cluelessgumshoe/3d_spidey-disc-launcher/mk3/images/mk3_cartridge_parts.png

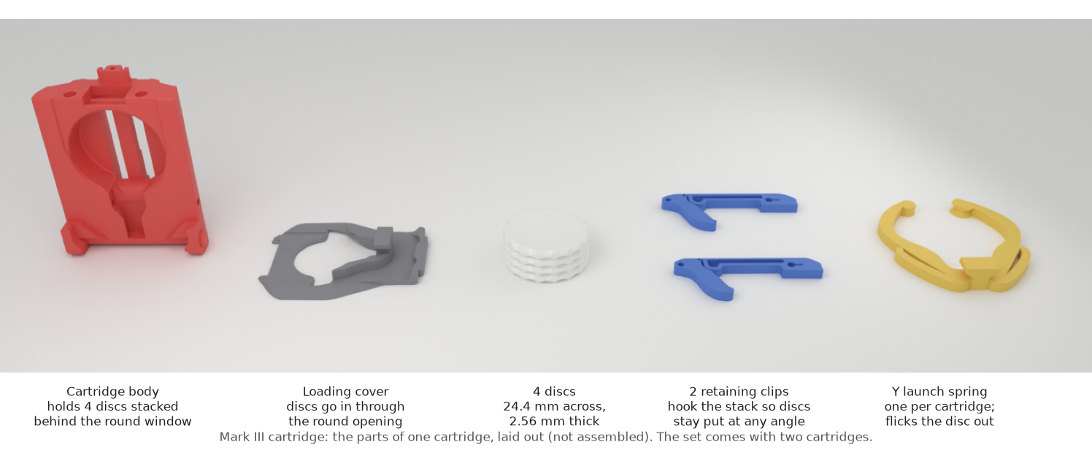
mk3/images/mk3_cartridge_parts.png
