cluelessgumshoe/3d_spidey-disc-launcher/mk3/stl/Assembly_part.stl

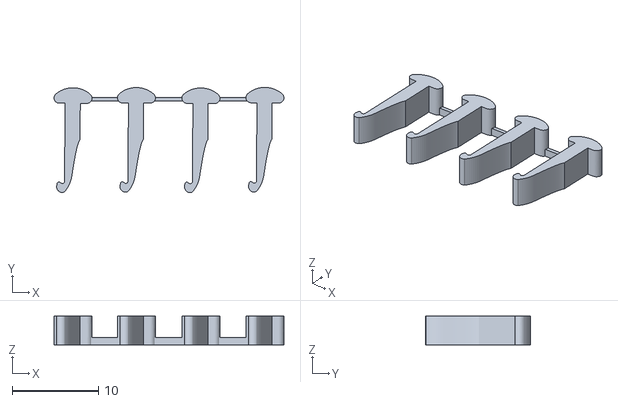
[picture p5: CAD file, 2026-10-16]
mk3/stl/Assembly_part.stl
26.7 x 12.2 x 3.33
