cluelessgumshoe/3d_spidey-disc-launcher/mk3/mk3_all_plates_kobra3.3mf

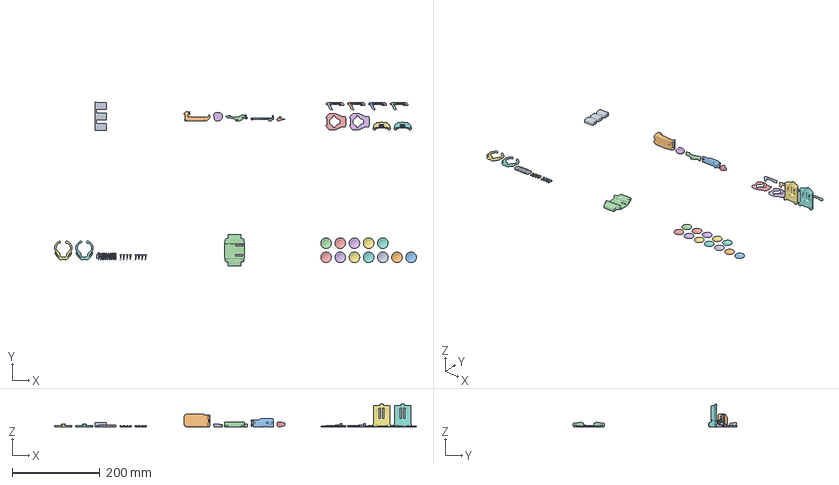
[picture p6: CAD file, 2026-10-30]
mk3/mk3_all_plates_kobra3.3mf
826.5 x 373.7 x 52.2 mm
watch_fit_coupon_v3
Pusher
Trigger_Lever
Trigger_PalmPad
Trigger_Button
Cartridge_Body_1
Cartridge_Body_2
Cartridge_Clip_C_1
Cartridge_Clip_C_2
Cartridge_Clip_D_1
Cartridge_Clip_D_2
Cartridge_LoadingCover_1
Cartridge_LoadingCover_2
Launch_Spring_Y_1
Launch_Spring_Y_2
Return_Spring_printed
Assembly_part_1
Assembly_part_2
wrist_base_watchband
Disc_small_1
Disc_small_2
Disc_small_3
Disc_small_4
Disc_small_5
Disc_small_6
Disc_small_7
Disc_small_8
Disc_small_9
Disc_small_10
Disc_small_11
Disc_small_12
