cluelessgumshoe/3d_spidey-disc-launcher/mk3/original/Launch_Spring_Y.stl

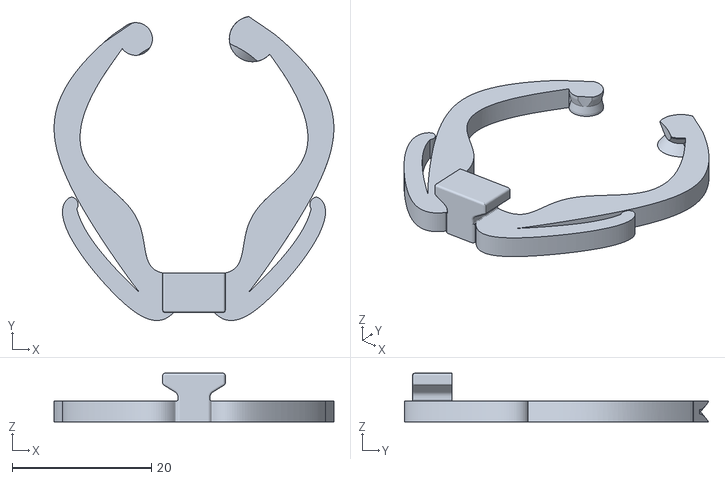
[picture p7: CAD file, 2026-10-16]
mk3/original/Launch_Spring_Y.stl
40.2 x 43.7 x 6.98
