cluelessgumshoe/3d_spidey-disc-launcher/mk3/plates/plate1_any_color_fit_test_v3_kobra3.3mf

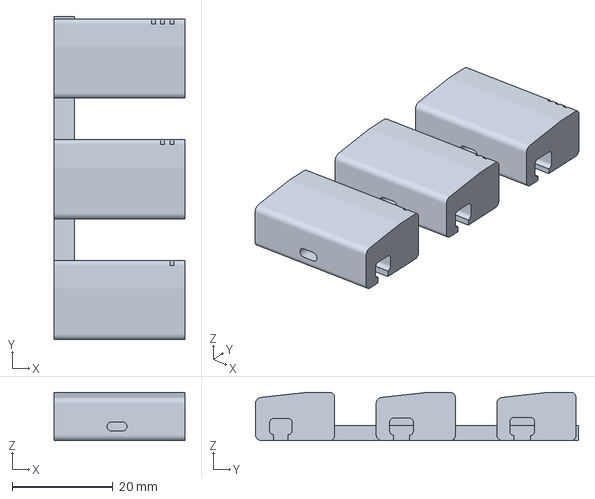
[picture p8: CAD file, 2026-10-30]
mk3/plates/plate1_any_color_fit_test_v3_kobra3.3mf
26.0 x 64.2 x 9.60 mm
