cluelessgumshoe/3d_spidey-disc-launcher/mk3/stl/Trigger_Lever.stl

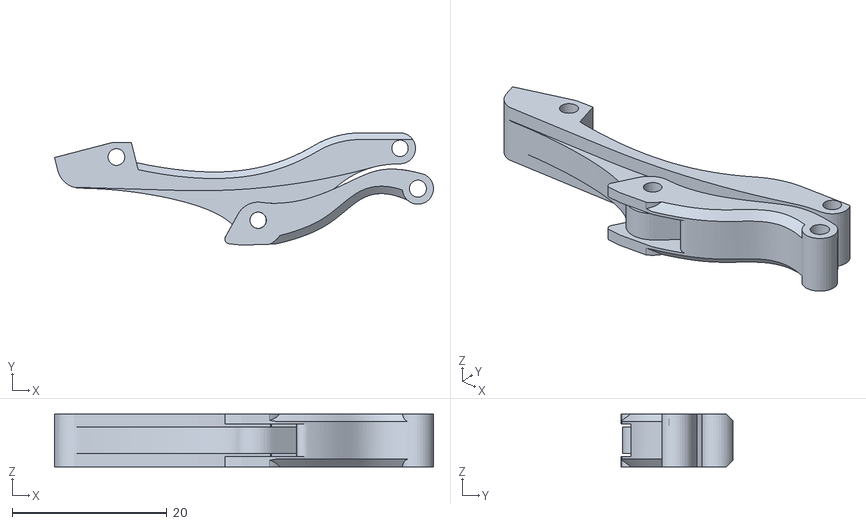
[picture p9: CAD file, 2026-10-16]
mk3/stl/Trigger_Lever.stl
48.9 x 14.5 x 6.84
