cluelessgumshoe/3d_spidey-disc-launcher/mk3/original/WristLock.stl

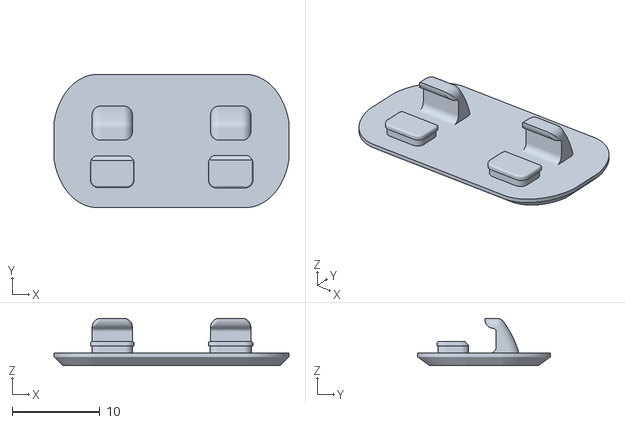
[picture p10: CAD file, 2026-10-16]
mk3/original/WristLock.stl
26.8 x 15.2 x 5.41
