cluelessgumshoe/3d_spidey-disc-launcher/mk3/plates/plate4_black_springs_and_pins_kobra3.3mf

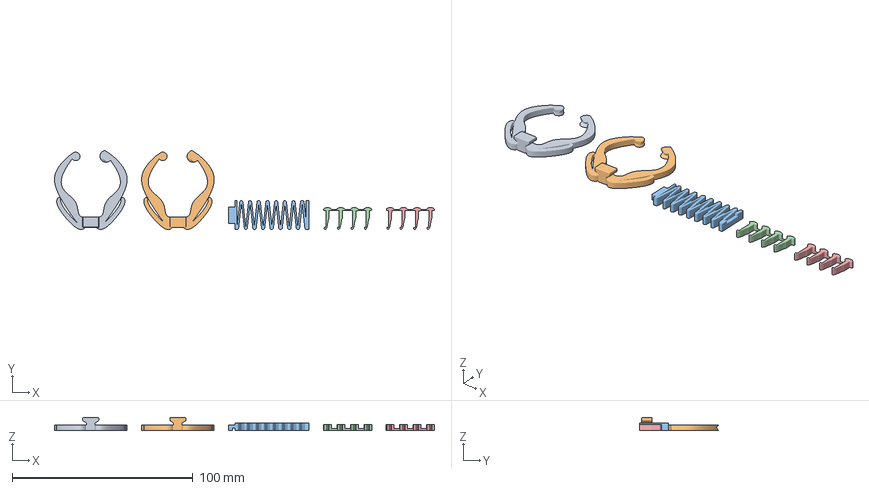
[picture p11: CAD file, 2026-10-30]
mk3/plates/plate4_black_springs_and_pins_kobra3.3mf
210.4 x 43.7 x 6.98 mm
Launch_Spring_Y_1
Launch_Spring_Y_2
Return_Spring_printed
Assembly_part_1
Assembly_part_2
