cluelessgumshoe/3d_spidey-disc-launcher/mk3/stl/Trigger_PalmPad.stl

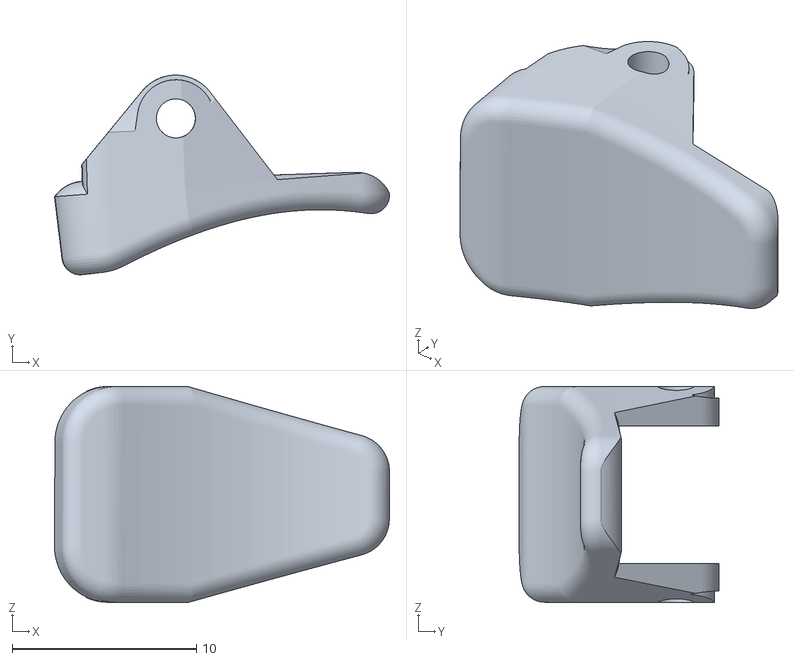
[picture p12: CAD file, 2026-10-16]
mk3/stl/Trigger_PalmPad.stl
18.2 x 10.8 x 11.7
