cluelessgumshoe/3d_spidey-disc-launcher/mk3/original/Cartridge_Clip_C.stl

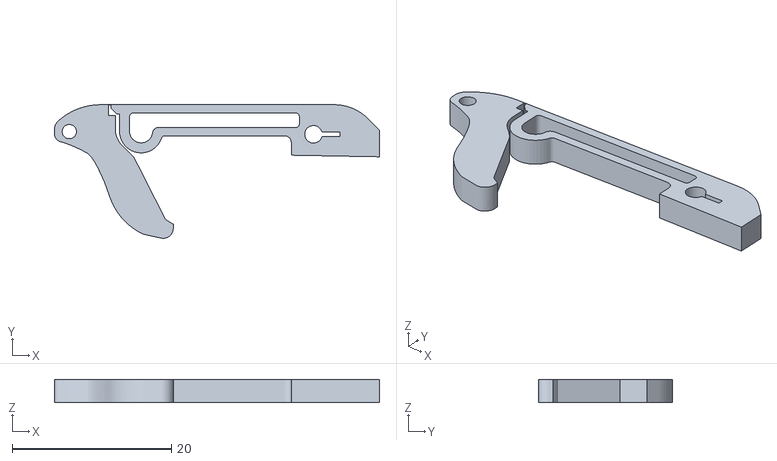
[picture p13: CAD file, 2026-10-16]
mk3/original/Cartridge_Clip_C.stl
40.8 x 16.8 x 2.90
