cluelessgumshoe/3d_spidey-disc-launcher/mk3/plates/plate2_red_launcher_kobra3.3mf

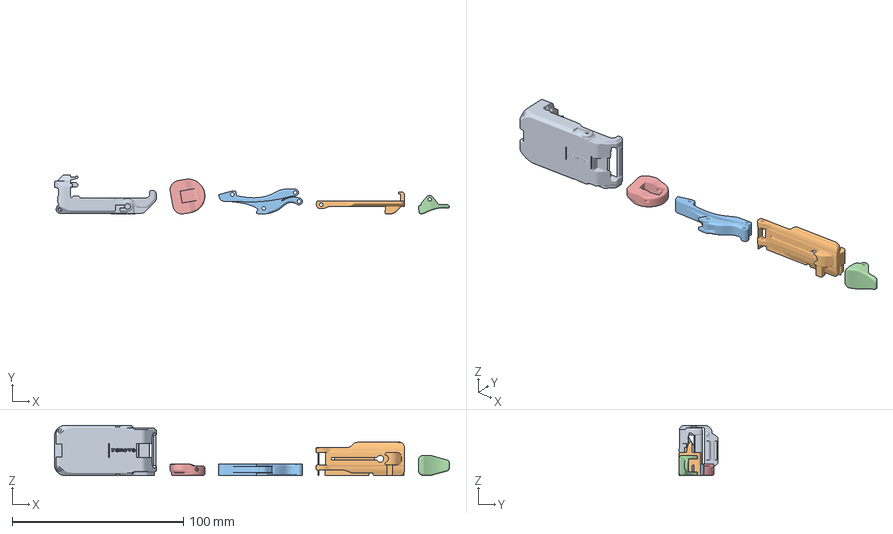
[picture p14: CAD file, 2026-10-30]
mk3/plates/plate2_red_launcher_kobra3.3mf
230.6 x 22.7 x 29.2 mm
Pusher
Trigger_Lever
Trigger_PalmPad
Trigger_Button
