cluelessgumshoe/3d_spidey-disc-launcher/mk3/original/WristStrap.stl

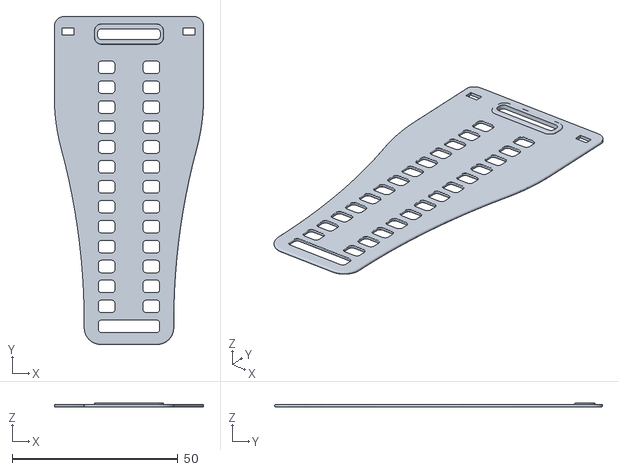
[picture p15: CAD file, 2026-10-16]
mk3/original/WristStrap.stl
45.0 x 98.8 x 1.20
