cluelessgumshoe/3d_spidey-disc-launcher/mk3/plates/plate3_black_cartridges_kobra3.3mf

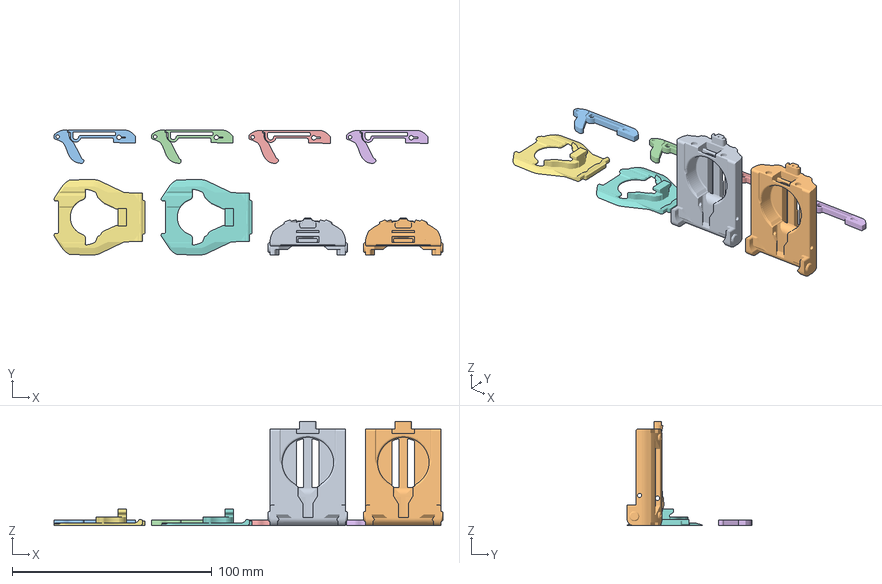
[picture p16: CAD file, 2026-10-30]
mk3/plates/plate3_black_cartridges_kobra3.3mf
194.9 x 62.7 x 52.2 mm
Cartridge_Body_1
Cartridge_Body_2
Cartridge_Clip_C_1
Cartridge_Clip_C_2
Cartridge_Clip_D_1
Cartridge_Clip_D_2
Cartridge_LoadingCover_1
Cartridge_LoadingCover_2
