cluelessgumshoe/3d_spidey-disc-launcher/mk3/plates/plate6_any_color_discs_kobra3.3mf

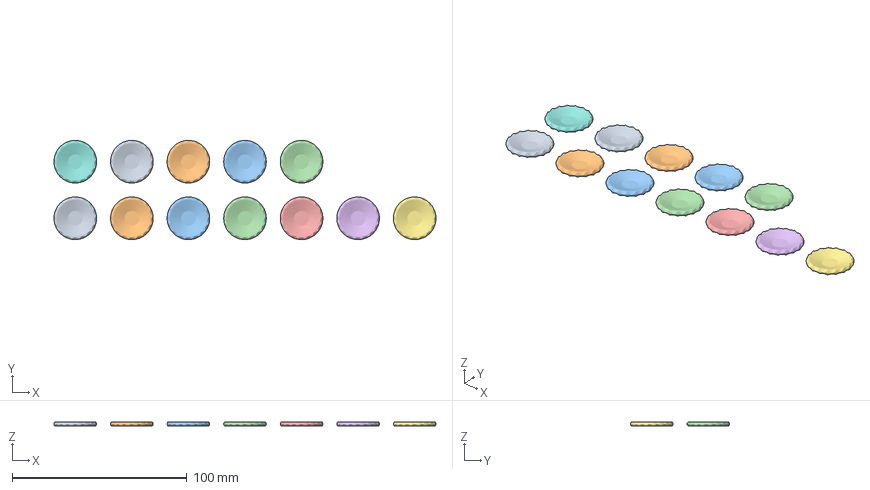
[picture p17: CAD file, 2026-10-30]
mk3/plates/plate6_any_color_discs_kobra3.3mf
218.6 x 56.7 x 2.56 mm
Disc_small_1
Disc_small_2
Disc_small_3
Disc_small_4
Disc_small_5
Disc_small_6
Disc_small_7
Disc_small_8
Disc_small_9
Disc_small_10
Disc_small_11
Disc_small_12
