cluelessgumshoe/3d_spidey-disc-launcher/mk3/stl/Pusher.stl

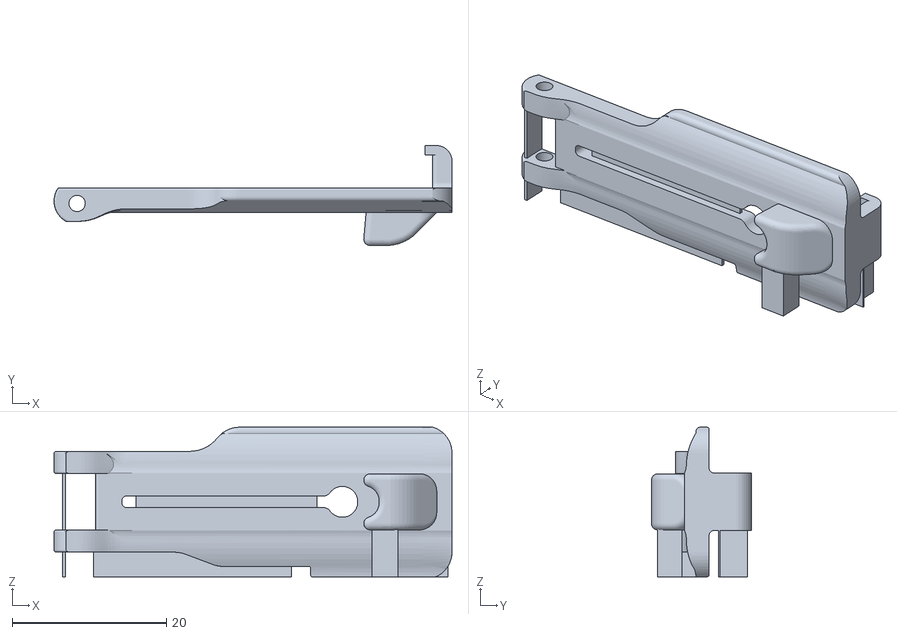
[picture p18: CAD file, 2026-10-16]
mk3/stl/Pusher.stl
51.6 x 13.0 x 19.4
