cluelessgumshoe/3d_spidey-disc-launcher/mk3/plates/plate5_red_wrist_base_kobra3.3mf

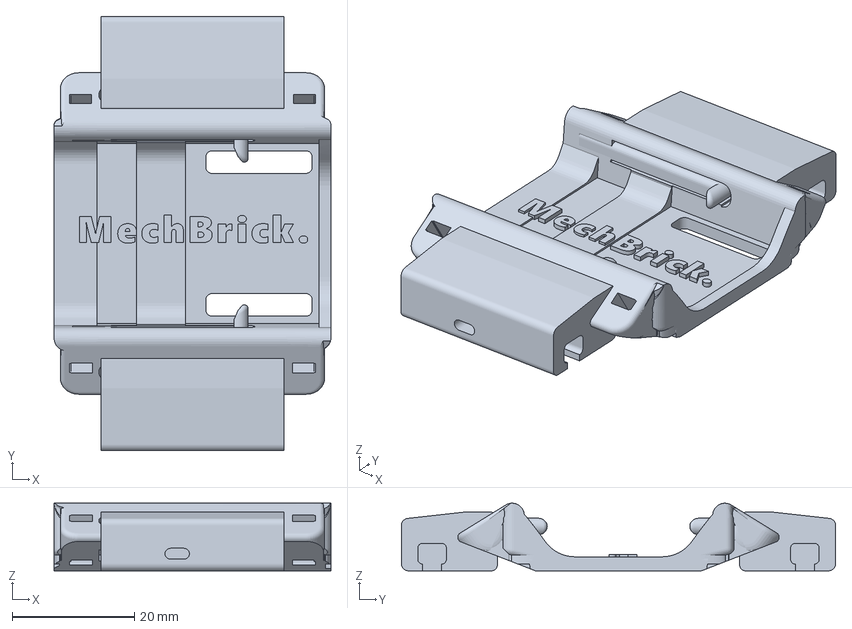
[picture p19: CAD file, 2026-10-30]
mk3/plates/plate5_red_wrist_base_kobra3.3mf
45.4 x 71.2 x 11.1 mm
