cluelessgumshoe/3d_spidey-disc-launcher/mk3/original/Cartridge_LoadingCover.stl

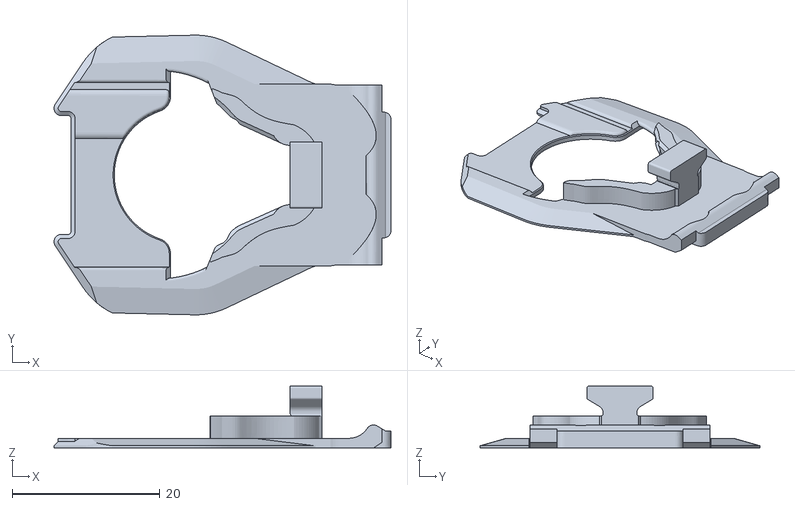
[picture p20: CAD file, 2026-10-16]
mk3/original/Cartridge_LoadingCover.stl
45.6 x 37.9 x 8.38
