cluelessgumshoe/3d_spidey-disc-launcher/mk3/original/Cartridge_Clip_D.stl

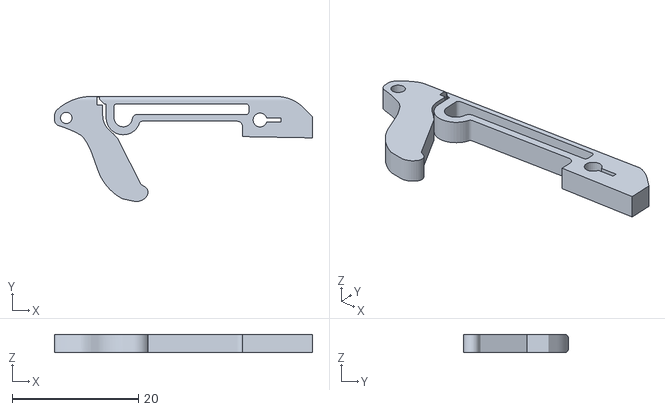
[picture p21: CAD file, 2026-10-16]
mk3/original/Cartridge_Clip_D.stl
40.8 x 16.6 x 2.90
