cluelessgumshoe/3d_spidey-disc-launcher/mk3/stl/Trigger_Button.stl

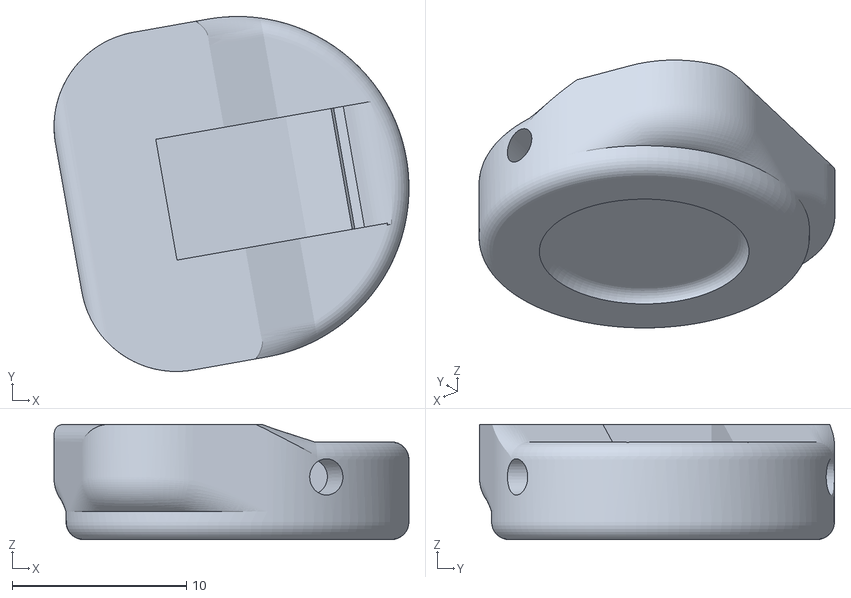
[picture p22: CAD file, 2026-10-16]
mk3/stl/Trigger_Button.stl
20.3 x 20.3 x 6.60
