cluelessgumshoe/3d_spidey-disc-launcher/mk3/original/WristBase.stl

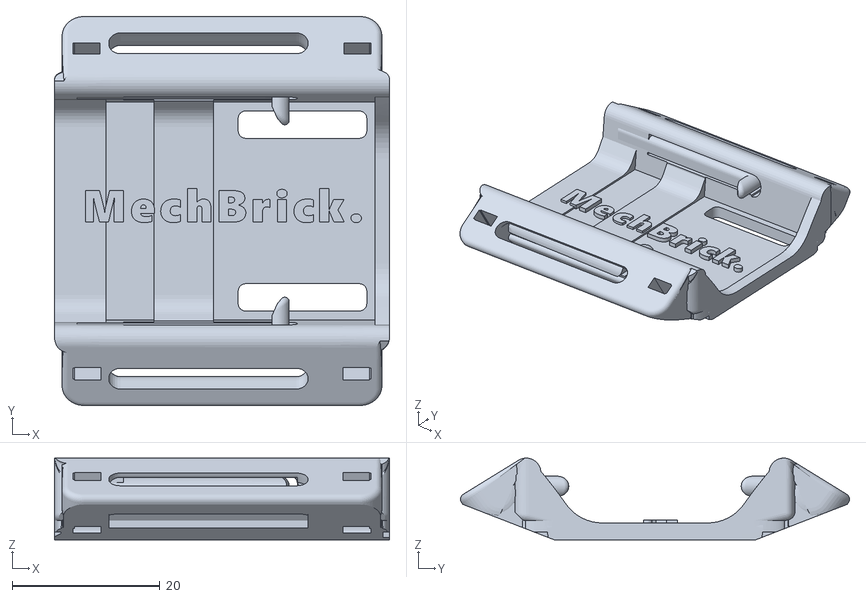
[picture p23: CAD file, 2026-10-16]
mk3/original/WristBase.stl
45.4 x 52.7 x 11.1
