cluelessgumshoe/3d_spidey-disc-launcher/mk3/stl/Disc_small.stl

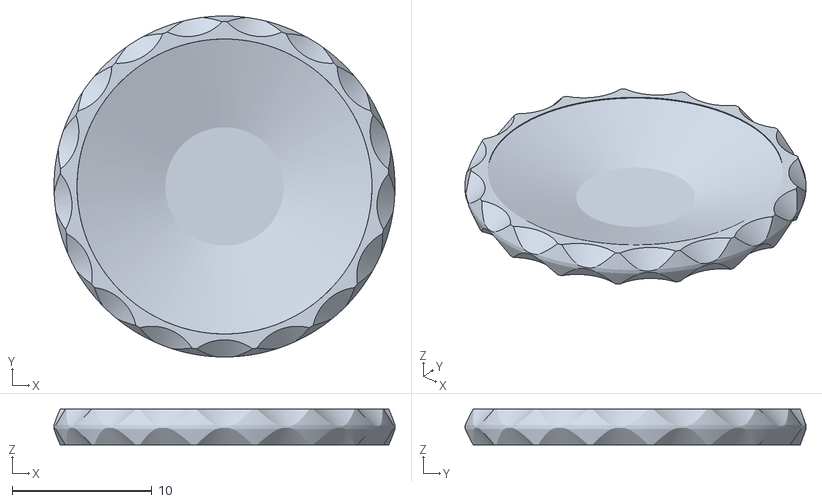
[picture p24: CAD file, 2026-10-16]
mk3/stl/Disc_small.stl
24.4 x 24.4 x 2.56
