cluelessgumshoe/3d_spidey-disc-launcher/mk3/stl/Cartridge_Body.stl

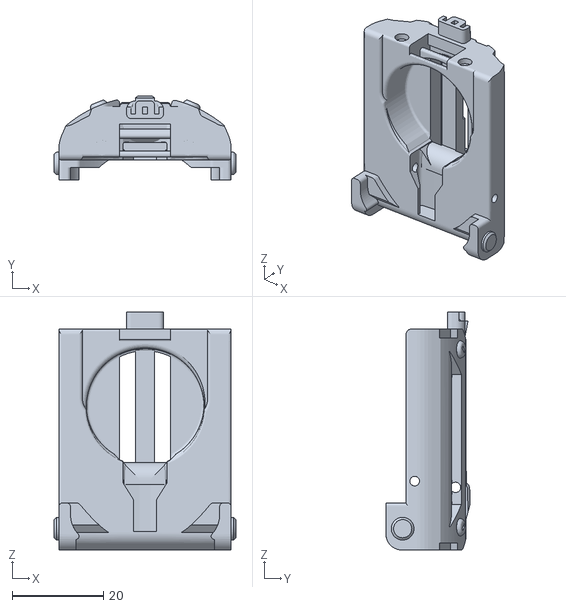
[picture p25: CAD file, 2026-10-16]
mk3/stl/Cartridge_Body.stl
39.8 x 18.5 x 52.2
