cluelessgumshoe/3d_spidey-disc-launcher/mk3/original/Return_Spring_printed.stl

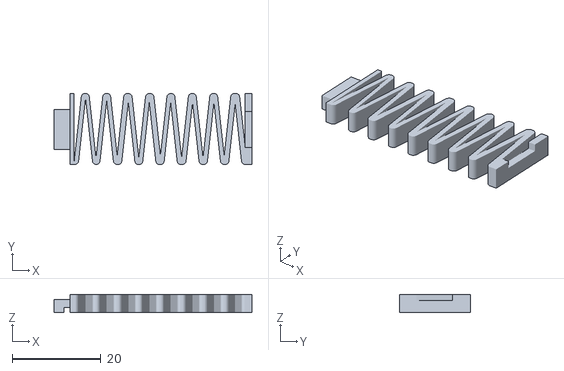
[picture p26: CAD file, 2026-10-16]
mk3/original/Return_Spring_printed.stl
44.5 x 16.0 x 4.14
