cluelessgumshoe/3d_spidey-disc-launcher/mk3/original/Body.stl

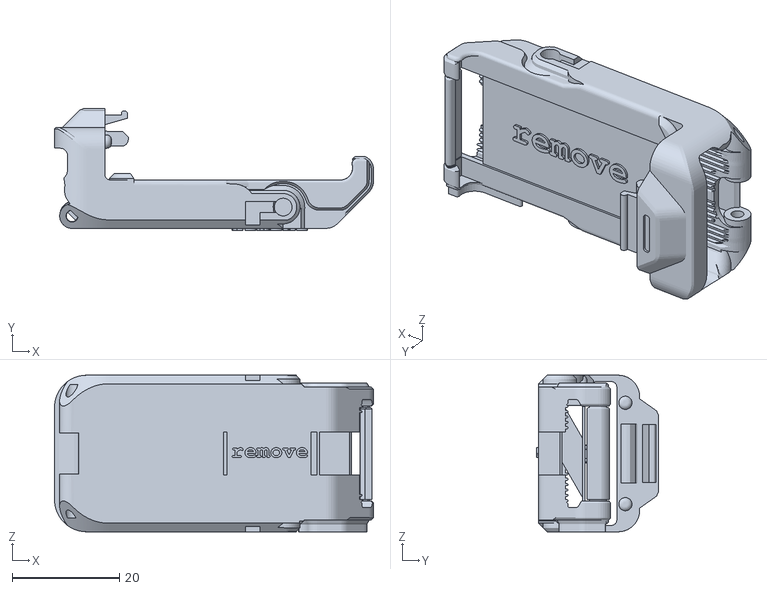
[picture p27: CAD file, 2026-10-16]
mk3/original/Body.stl
59.5 x 22.7 x 29.2
