cluelessgumshoe/3d_spidey-disc-launcher/mk3/original/WristStrap_L.stl

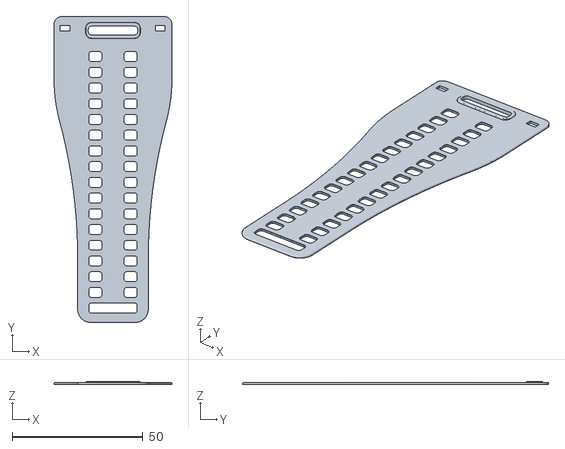
[picture p28: CAD file, 2026-10-16]
mk3/original/WristStrap_L.stl
45.0 x 116.8 x 1.20
