cluelessgumshoe/3d_spidey-disc-launcher/(list of files, cad)

Other CAD files:
mk3/stl/watch_fit_coupon_v3.stl
mk3/original/Trigger_Lever.stl
mk3/stl/wrist_base_watchband.stl
mk1/original/DWS_Main_Body_Short_v2.stl
mk1/original/DWS_WristMount_Body_v4.stl
mk1/original/Disc.stl
mk1/original/parts/Link2_Cap.stl
mk1/original/parts/Link2_Lever.stl
mk1/original/parts/Link3.stl
mk1/original/parts/Link3_Pad.stl
mk1/original/parts/Pusher_A.stl
mk1/original/parts/Pusher_B.stl
mk1/original/parts/Slider.stl
mk1/original/parts/Slider_Retainer.stl
mk1/original/parts/Spring.stl
mk1/original/parts/SpringLockPin.stl
mk1/plates/optional_plate_only_kobra3.3mf
mk1/plates/plate1_any_color_fit_test_kobra3.3mf
mk1/plates/plate2_red_launcher_kobra3.3mf
mk1/plates/plate3_black_mechanism_kobra3.3mf
mk1/plates/plate4_any_color_discs_kobra3.3mf
mk1/plates/plate5_black_belt_canister_kobra3.3mf
mk1/spidey_launcher_all_plates_kobra3.3mf
mk1/stl/Disc.stl
mk1/stl/Disc_101.5pct.stl
mk1/stl/Disc_101pct.stl
mk1/stl/Link2_Cap.stl
mk1/stl/Link2_Lever.stl
mk1/stl/Link2_Lever_bent_10deg.stl
mk1/stl/Link2_Lever_bent_20deg.stl
mk1/stl/Link3.stl
mk1/stl/Link3_Pad.stl
mk1/stl/Pusher_A.stl
mk1/stl/Pusher_B.stl
mk1/stl/Slider.stl
mk1/stl/Slider_Retainer.stl
mk1/stl/Spring.stl
mk1/stl/SpringLockPin.stl
mk1/stl/belt_canister.stl
mk1/stl/belt_cap.stl
mk1/stl/belt_follower.stl
mk1/stl/launcher_one_piece.stl
mk1/stl/spring_grip_coupon.stl
mk1/stl/watch_fit_coupon.stl
mk1/stl/wrist_plate.stl
