cluelessgumshoe/3d_spidey-disc-launcher/(commit log)

2026-10-16 Spidey disc launcher fork: one-piece body with watch band rails
    Remix of MechBrick's Spidey Disc Launcher MK-I. Fuses the launcher body
    to a new wrist plate with Apple Watch band rails (replacing the snap-hook
    cuff that kept breaking), adds a band fit coupon and a 12-disc belt
    canister, and lays out every part on red and black print plates for the
    Kobra 3.
    [DWS_Main_Body_Short_v2.stl, DWS_WristMount_Body_v4.stl, Disc.stl, Link2_Cap.stl, Link2_Lever.stl, Link3.stl, Link3_Pad.stl, Pusher_A.stl]
2026-10-16 One project 3MF with all six plates, plus STLs of every part
    spidey_launcher_all_plates_kobra3.3mf uses the Bambu Studio project
    layout (per-object model files and Metadata/model_settings.config) so
    Anycubic Slicer Next / OrcaSlicer open every plate at once. The
    single-plate files move to plates/ as a fallback, and stl/ now has the
    original mechanism parts and disc too.
    [Disc.stl, Link2_Cap.stl, Link2_Lever.stl, Link3.stl, Link3_Pad.stl, Pusher_A.stl, Pusher_B.stl, Slider.stl]
2026-10-16 Tighter watch band coupon v2 with a latch slot
    Coupon v1: the -0.15 slot fits but the band pulls out. v2 tests -0.20,
    -0.25 and -0.30, keeps the slot bottoms closed, and stretches the latch
    hole into a 4 mm slot where a 41 or 45 mm band's latch lands when pushed
    all the way down. Plate rails get the same latch slot and FIT -0.15.
    [launcher_one_piece.stl, optional_plate_only_kobra3.3mf, plate1_any_color_fit_test_kobra3.3mf, plate2_red_launcher_kobra3.3mf, plate3_black_mechanism_kobra3.3mf, plate4_red_discs_kobra3.3mf, plate5_black_belt_canister_kobra3.3mf, spidey_launcher_all_plates_kobra3.3mf]
2026-10-16 Space plates for the Kobra 3's 255 mm bed so the slicer lines them up
    Anycubic Slicer Next (OrcaSlicer based) rebuilds plate membership from
    part positions, with plates 1.2 bed widths apart. The Kobra 3 profile
    bed is 255 mm, not 250, so plates were 6 to 12 mm off.
    [optional_plate_only_kobra3.3mf, plate1_any_color_fit_test_kobra3.3mf, plate2_red_launcher_kobra3.3mf, plate3_black_mechanism_kobra3.3mf, plate4_red_discs_kobra3.3mf, plate5_black_belt_canister_kobra3.3mf, spidey_launcher_all_plates_kobra3.3mf]
2026-10-16 Launcher rails use the tested band fit: -0.20, closed end, latch 11 mm in
    Coupon v2's one-notch slot (-0.20) fits and clicks, so the rails on the
    one-piece and the plate-only part now match it exactly: same slot size,
    slot closed at the ramp end, and the latch slot 11 mm from that stop.
    [launcher_one_piece.stl, optional_plate_only_kobra3.3mf, plate1_any_color_fit_test_kobra3.3mf, plate2_red_launcher_kobra3.3mf, plate3_black_mechanism_kobra3.3mf, plate4_red_discs_kobra3.3mf, plate5_black_belt_canister_kobra3.3mf, spidey_launcher_all_plates_kobra3.3mf]
2026-10-16 README: print the launch springs in plain PLA, as MechBrick recommends
2026-10-16 Start Mark III v2 in mk3/: watch band wrist base, flat fit coupon v3, plates
    MechBrick's Mark III (4-disc quick-eject cartridge) with the strap and
    lock replaced by Apple Watch band rails on the wrist base. The launcher
    side of the base is unchanged; rails open downward so the base still
    prints flat, with a flat-printed fit coupon v3 to set the slot size.
    All Mark III parts are laid out on six plates. MK-I stays at the root
    (tagged mk1-v1). Also adds the belt canister and cartridge pictures.
    [Assembly_part.stl, Body.stl, Cartridge_Body.stl, Cartridge_Clip_C.stl, Cartridge_Clip_D.stl, Cartridge_LoadingCover.stl, Disc_small.stl, Launch_Spring_Y.stl]
2026-10-30 MK-I v2 one-piece: plate under the whole body, fully fused, band 5 mm toward elbow
    v1 snapped at the elbow end, where the body hung 22 mm past the plate
    with print layers running across it. v2 carries the plate out under the
    whole body and fills every gap between them (except the trigger link's
    slot), fuses the pin tabs and knuckles into solid blocks with the pin
    bore kept, fills the four leftover mount holes flush, and moves the band
    rails 5 mm toward the elbow. Adds bent-lever (10 and 20 deg) and bigger
    disc (101 and 101.5%) test prints from the 2026-10-30 feedback.
    [Disc_101.5pct.stl, Disc_101pct.stl, Link2_Lever_bent_10deg.stl, Link2_Lever_bent_20deg.stl, launcher_one_piece.stl, optional_plate_only_kobra3.3mf, plate1_any_color_fit_test_kobra3.3mf, plate2_red_launcher_kobra3.3mf]
2026-10-30 Belt canister v2: bottom-dispensing with a snap-on cap
    From the 2026-10-30 feedback (the discs just sat in an open tube): load
    from the top under a snap-on cap, take discs out the bottom through a
    one-disc-high front exit slot with a finger slot in the floor and a
    keeper ridge at the exit. Gravity feeds the next disc, no spring.
    Simulated: 12 discs (and the 101/101.5% test sizes) fit, the cap seats
    with no interference, one disc slides out and the next is blocked.
    [belt_canister.stl, belt_cap.stl, optional_plate_only_kobra3.3mf, plate1_any_color_fit_test_kobra3.3mf, plate2_red_launcher_kobra3.3mf, plate3_black_mechanism_kobra3.3mf, plate4_any_color_discs_kobra3.3mf, plate5_black_belt_canister_kobra3.3mf]
2026-10-30 Reorganize into mk1/ and mk3/ folders with a top-level README
    The MK-I fork moves into mk1/ (history kept with git mv); the Mark III
    work stays in mk3/ and now imports the shared helpers from mk1/. Both
    generators rebuild the same parts from their new folders.
    [DWS_Main_Body_Short_v2.stl, DWS_WristMount_Body_v4.stl, Disc.stl, Disc_101.5pct.stl, Disc_101pct.stl, Link2_Cap.stl, Link2_Lever.stl, Link2_Lever_bent_10deg.stl]
2026-10-30 Belt canister v3: screw cap, spring and follower
    The cap screws onto a threaded neck above the belt loop. A flat follower
    rides on the stack with the 5.5 x 38 mm metal spring above it, so the
    discs stay flat and feed down; it pushes until about 4 are left.
    [belt_canister.stl, belt_cap.stl, belt_follower.stl, optional_plate_only_kobra3.3mf, plate1_any_color_fit_test_kobra3.3mf, plate2_red_launcher_kobra3.3mf, plate3_black_mechanism_kobra3.3mf, plate4_any_color_discs_kobra3.3mf]
2026-10-31 Canister v3: spring twists into sockets in the cap and follower
    Cap, spring and follower now come out together instead of the spring
    falling loose. Adds a spring grip test print (5.0 / 5.2 / 5.4 mm).
    [belt_cap.stl, belt_follower.stl, optional_plate_only_kobra3.3mf, plate1_any_color_fit_test_kobra3.3mf, plate2_red_launcher_kobra3.3mf, plate3_black_mechanism_kobra3.3mf, plate4_any_color_discs_kobra3.3mf, plate5_black_belt_canister_kobra3.3mf]
